hulakov/NosLed/hardware/NosLed.kicad_pcb

## KiCad design hardware/NosLed.kicad_pcb (2026-04-08)

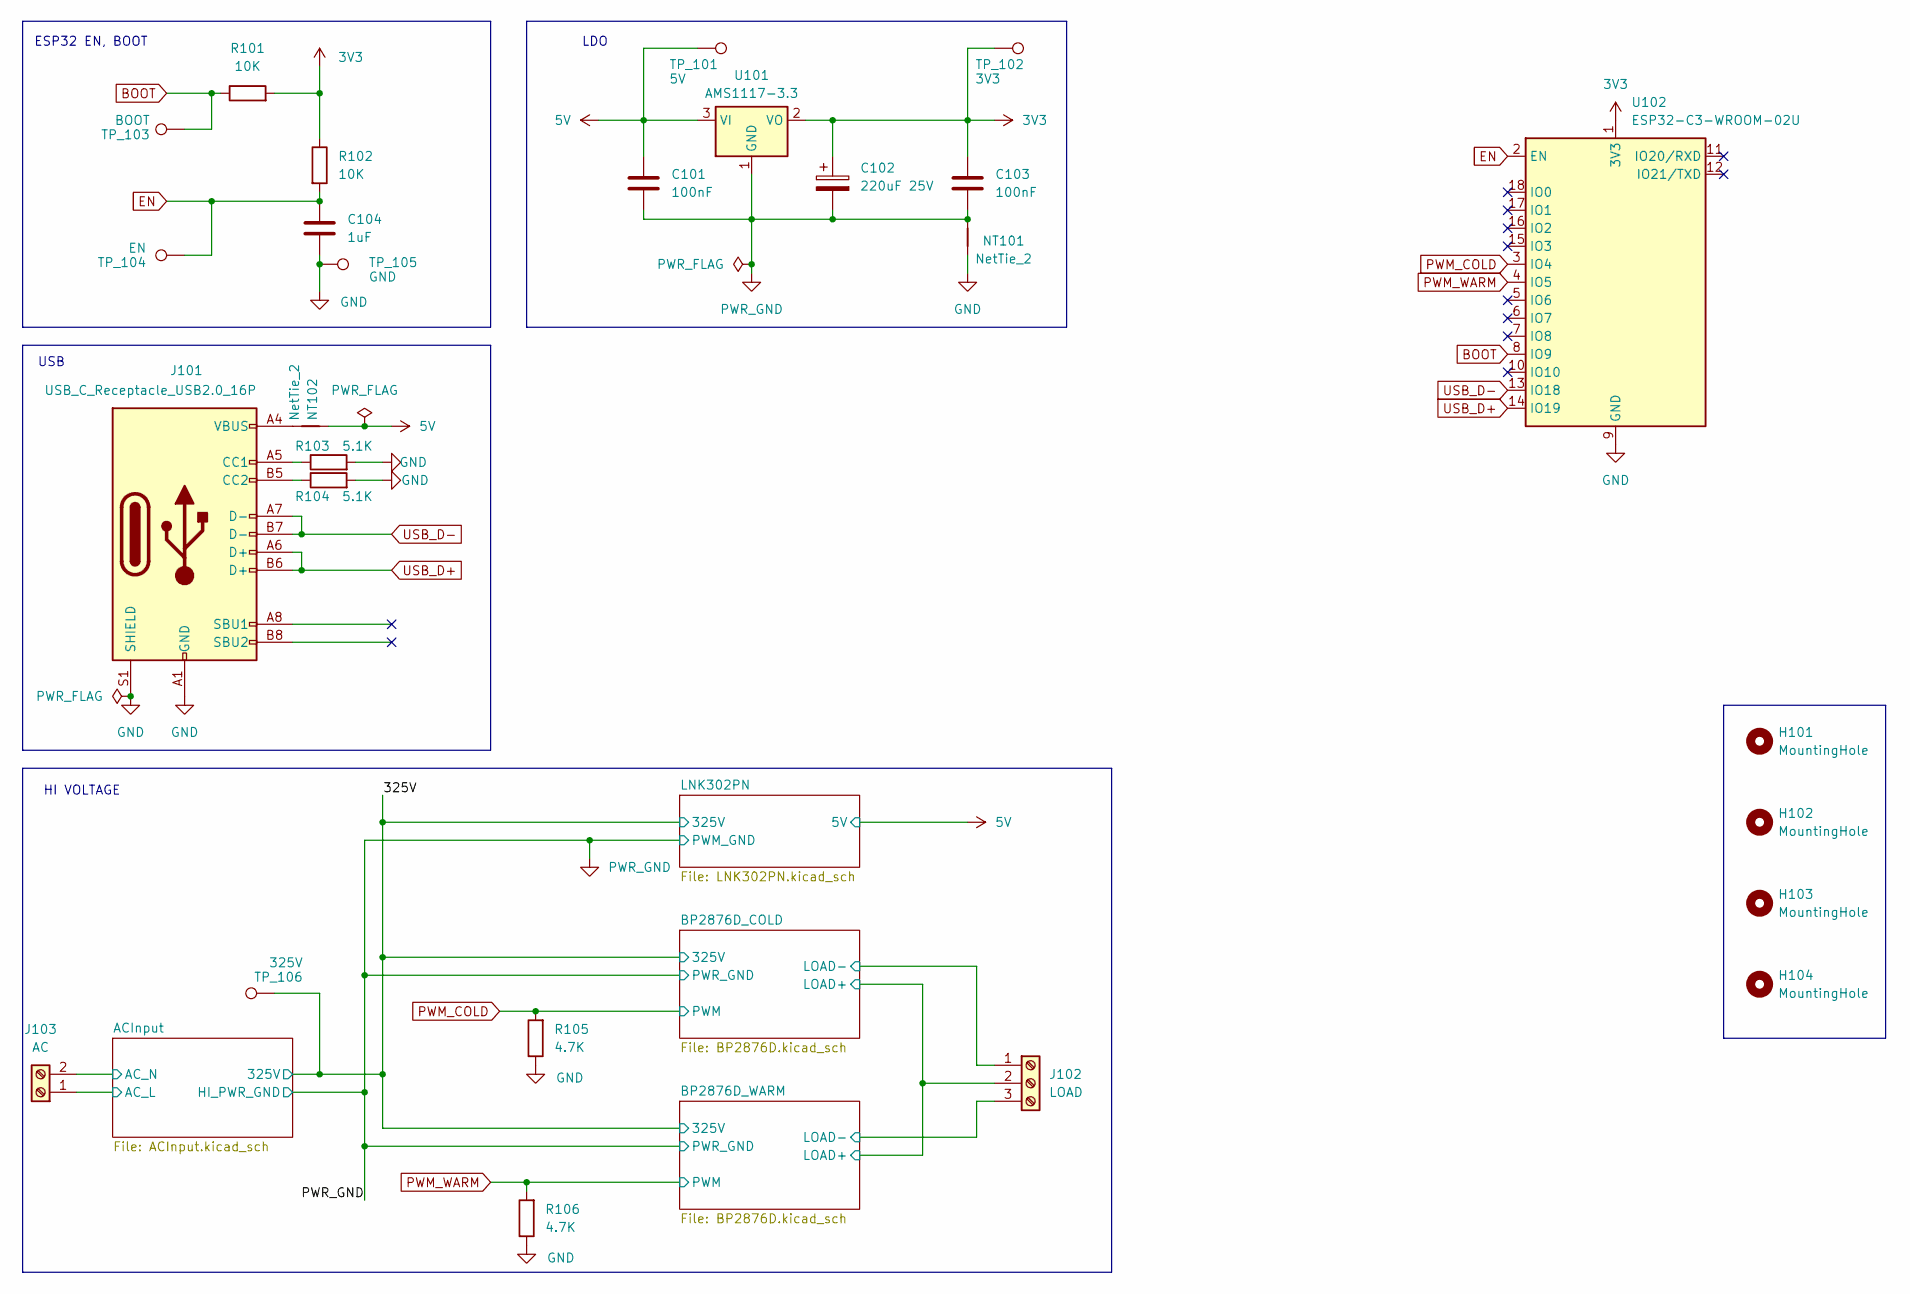
[picture p1: schematic NosLed.kicad_sch]

Parts:
C101, C103: 100nF; C_0603_1608Metric
C102: 220uF 25V; CP_Radial_D6.3mm_P2.50mm
C104: 1uF; C_0805_2012Metric
H101, H102, H103, H104: MountingHole; MountingHole_3.2mm_M3
J101: USB_C_Receptacle_USB2.0_16P; USB_C_Receptacle_HRO_TYPE-C-31-M-12
J102: LOAD; TerminalBlock_Phoenix_MKDS-1,5-3-5.08_1x03_P5.08mm_Horizont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
J103: AC; TerminalBlock_Phoenix_MKDS-1,5-2-5.08_1x02_P5.08mm_Horizont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
NT101, NT102: NetTie_2; NetTie-2_SMD_Pad0.5mm
R101, R102: 10K; R_0603_1608Metric
R103, R104: 5.1K; R_0603_1608Metric
R105, R106: 4.7K; R_0603_1608Metric
TP_101: 5V; TestPoint_Pad_1.0x1.0mm
TP_102: 3V3; TestPoint_Pad_1.0x1.0mm
TP_103: BOOT; TestPoint_Pad_1.0x1.0mm
TP_104: EN; TestPoint_Pad_1.0x1.0mm
TP_105: GND; TestPoint_Pad_1.0x1.0mm
TP_106: 325V; TestPoint_Pad_1.0x1.0mm
U101: AMS1117-3.3; SOT-223-3_TabPin2
U102: ESP32-C3-WROOM-02U

Connections:
3V3: C102.1, C103.2, R101.2, R102.1, TP_102.1, U101.2 (VO), U102.1 (3V3)
5V: C101.2, NT102.2, TP_101.1, U101.3 (VI); also elsewhere on the board
/325V: J102.2, TP_106.1; also elsewhere on the board
/ACInput/AC_L: J103.1; also elsewhere on the board
/ACInput/AC_N: J103.2; also elsewhere on the board
/BP2876D_COLD/LOAD-: J102.1; also elsewhere on the board
/BP2876D_WARM/LOAD-: J102.3; also elsewhere on the board
BOOT: R101.1, TP_103.1, U102.8 (IO9)
EN: C104.1, R102.2, TP_104.1, U102.2 (EN)
GND: C104.2, J101.A1 (GND), J101.A12 (GND), J101.B1 (GND), J101.B12 (GND), J101.S1 (SHIELD), NT101.2, R103.2, R104.2, R105.1, R106.1, TP_105.1, U102.9 (GND), U102.19 (GND); also elsewhere on the board
unnamed: J101.A5 (CC1), R103.1
unnamed: J101.B5 (CC2), R104.1
unnamed: J101.A4 (VBUS), J101.A9 (VBUS), J101.B4 (VBUS), J101.B9 (VBUS), NT102.1
PWM_COLD: R105.2, U102.3 (IO4); also elsewhere on the board
PWM_WARM: R106.2, U102.4 (IO5); also elsewhere on the board
PWR_GND: C101.1, C102.2, C103.1, NT101.1, U101.1 (GND); also elsewhere on the board
USB_D+: J101.A6 (D+), J101.B6 (D+), U102.14 (IO19)
USB_D-: J101.A7 (D-), J101.B7 (D-), U102.13 (IO18)

Notes on the sheet:
LDO
ESP32 EN, BOOT
HI VOLTAGE
USB

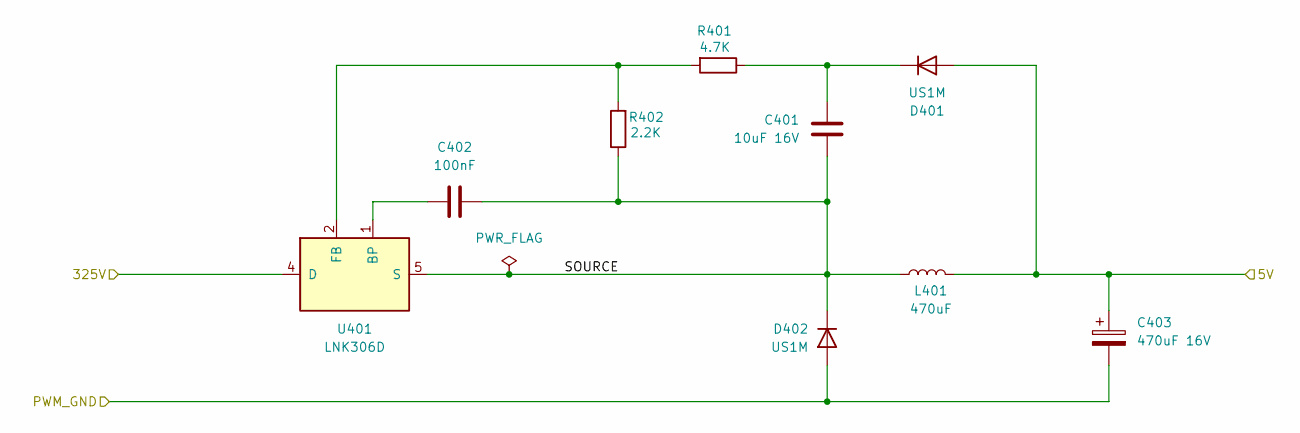
[picture p2: schematic LNK302PN.kicad_sch]

Parts:
C401: 10uF 16V; C_0805_2012Metric
C402: 100nF; C_0603_1608Metric
C403: 470uF 16V; CP_Radial_D8.0mm_P5.00mm
D401, D402: US1M; D_SMA
L401: 470uF; L_Radial_D9.5mm_P5.00mm_Fastron_07HVP
R401: 4.7K; R_0603_1608Metric
R402: 2.2K; R_0603_1608Metric
U401: LNK306D; LNK302PN-SOIC-8_3.9x4.9mm_P1.27mm

Connections:
5V: C403.1, D401.2 (A), L401.2; also elsewhere on the board
/325V: U401.4 (D); also elsewhere on the board
/LNK302PN/SOURCE: C401.1, C402.1, D402.1 (K), L401.1, R402.1, U401.5 (S), U401.6 (S), U401.7 (S), U401.8 (S)
unnamed: C401.2, D401.1 (K), R401.1
unnamed: C402.2, U401.1 (BP)
unnamed: R401.2, R402.2, U401.2 (FB)
PWR_GND: C403.2, D402.2 (A); also elsewhere on the board

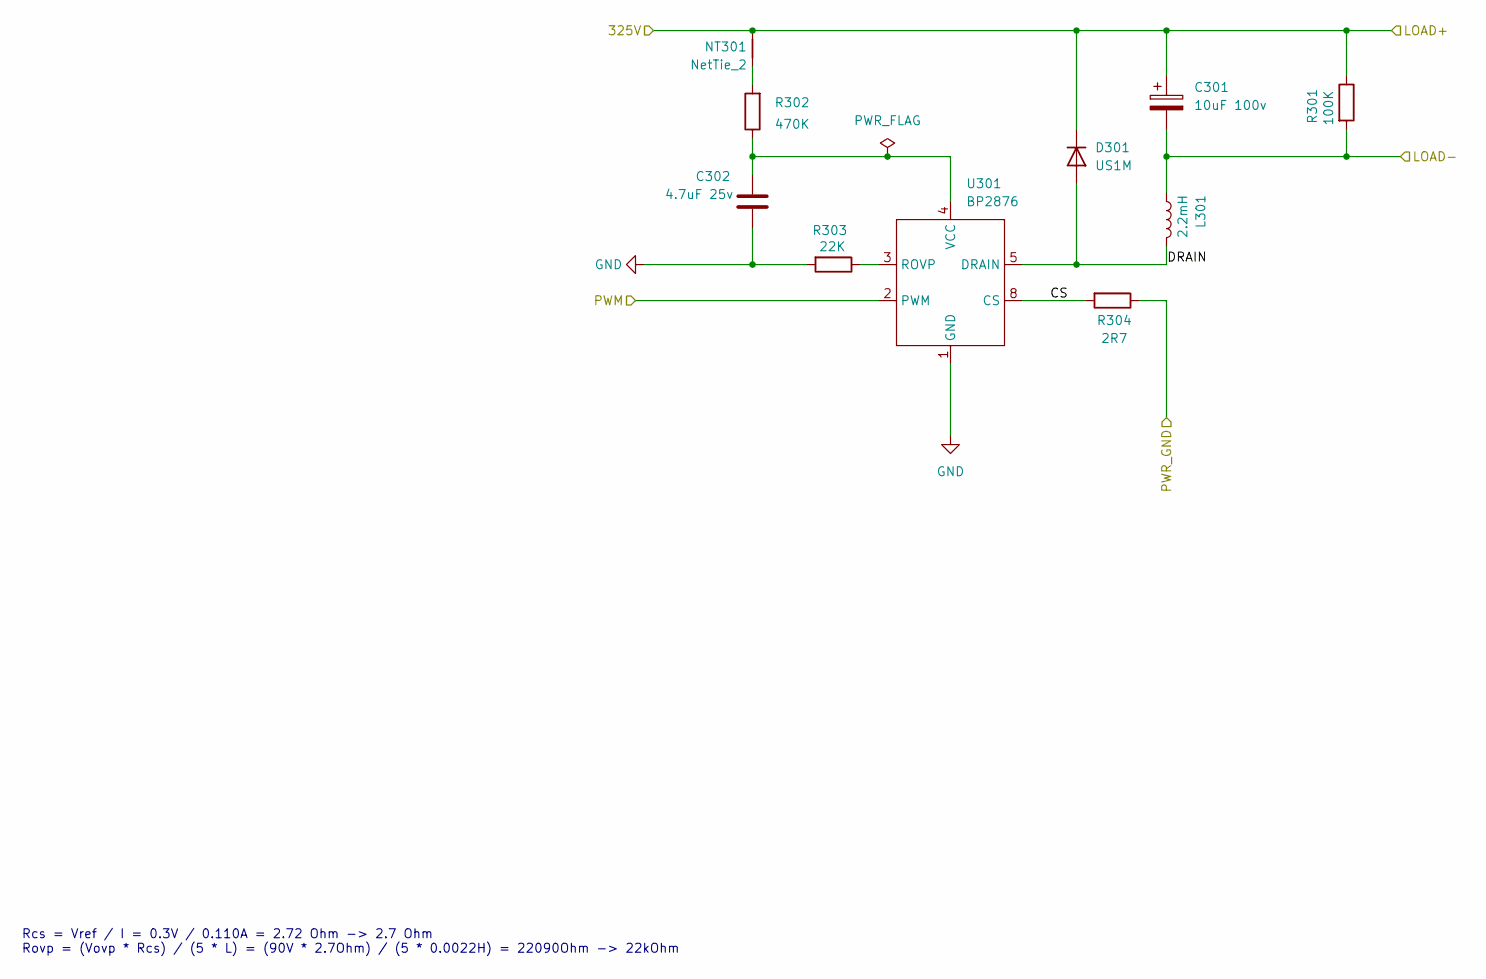
[picture p3: schematic BP2876D.kicad_sch]

Parts:
C301: 10uF 100v; CP_Radial_D6.3mm_P2.50mm
C302: 4.7uF 25v; C_0805_2012Metric
D301: US1M; D_SMA
L301: 2.2mH; L_Radial_D9.5mm_P5.00mm_Fastron_07HVP
NT301: NetTie_2; NetTie-2_SMD_Pad0.5mm
R301: 100К; R_1206_3216Metric
R302: 470K; R_2512_6332Metric
R303: 22K; R_0603_1608Metric
R304: 2R7; R_0805_2012Metric
U301: BP2876; SOIC-8-N7_3.9x4.9mm_P1.27mm

Connections:
/325V: C301.1, D301.1 (K), NT301.2, R301.1; also elsewhere on the board
/BP2876D_WARM/CS: R304.2, U301.8 (CS)
/BP2876D_WARM/DRAIN: D301.2 (A), L301.2, U301.5 (DRAIN), U301.6 (DRAIN)
/BP2876D_WARM/LOAD-: C301.2, L301.1, R301.2; also elsewhere on the board
GND: C302.2, R303.2, U301.1 (GND); also elsewhere on the board
unnamed: NT301.1, R302.2
unnamed: R303.1, U301.3 (ROVP)
unnamed: C302.1, R302.1, U301.4 (VCC)
PWM_WARM: U301.2 (PWM); also elsewhere on the board
PWR_GND: R304.1; also elsewhere on the board

Parts of its further copies:
C501: 10uF 100v; CP_Radial_D6.3mm_P2.50mm
C502: 4.7uF 25v; C_0805_2012Metric
D501: US1M; D_SMA
L501: 2.2mH; L_Radial_D9.5mm_P5.00mm_Fastron_07HVP
NT501: NetTie_2; NetTie-2_SMD_Pad0.5mm
R501: 100К; R_1206_3216Metric
R502: 470K; R_2512_6332Metric
R503: 22K; R_0603_1608Metric
R504: 2R7; R_0805_2012Metric
U501: BP2876; SOIC-8-N7_3.9x4.9mm_P1.27mm

Connections of its further copies:
/325V: C501.1, D501.1 (K), NT501.2, R501.1; also elsewhere on the board
/BP2876D_COLD/CS: R504.2, U501.8 (CS)
/BP2876D_COLD/DRAIN: D501.2 (A), L501.2, U501.5 (DRAIN), U501.6 (DRAIN)
/BP2876D_COLD/LOAD-: C501.2, L501.1, R501.2; also elsewhere on the board
GND: C502.2, R503.2, U501.1 (GND); also elsewhere on the board
unnamed: NT501.1, R502.2
unnamed: R503.1, U501.3 (ROVP)
unnamed: C502.1, R502.1, U501.4 (VCC)
PWM_COLD: U501.2 (PWM); also elsewhere on the board
PWR_GND: R504.1; also elsewhere on the board

Notes on the sheet:
Rcs = Vref / I = 0.3V / 0.110A = 2.72 Ohm -> 2.7 Ohm Rovp = (Vovp * Rcs) / (5 * L) = (90V * 2.7Ohm) / (5 * 0.0022H) = 22090Ohm -> 22kOhm

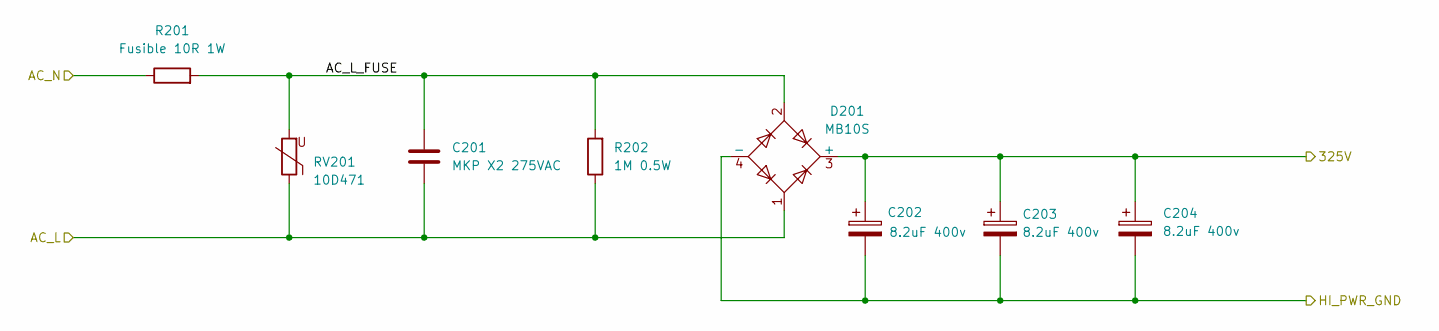
[picture p4: schematic ACInput.kicad_sch]

Parts:
C201: MKP X2 275VAC; C_Rect_L13.0mm_W6.0mm_P10.00mm_FKS3_FKP3_MKS4
C202, C203, C204: 8.2uF 400v; CP_Radial_D8.0mm_P3.50mm
D201: MB10S; TO-269AA
R201: Fusible 10R 1W; R_Axial_DIN0414_L11.9mm_D4.5mm_P15.24mm_Horizontal
R202: 1M 0.5W; R_2512_6332Metric
RV201: 10D471; RV_Disc_D12mm_W4.8mm_P7.5mm

Connections:
/325V: C202.1, C203.1, C204.1, D201.3 (+); also elsewhere on the board
/ACInput/AC_L: C201.2, D201.1, R202.1, RV201.1; also elsewhere on the board
/ACInput/AC_L_FUSE: C201.1, D201.2, R201.2, R202.2, RV201.2
/ACInput/AC_N: R201.1; also elsewhere on the board
PWR_GND: C202.2, C203.2, C204.2, D201.4 (-); also elsewhere on the board

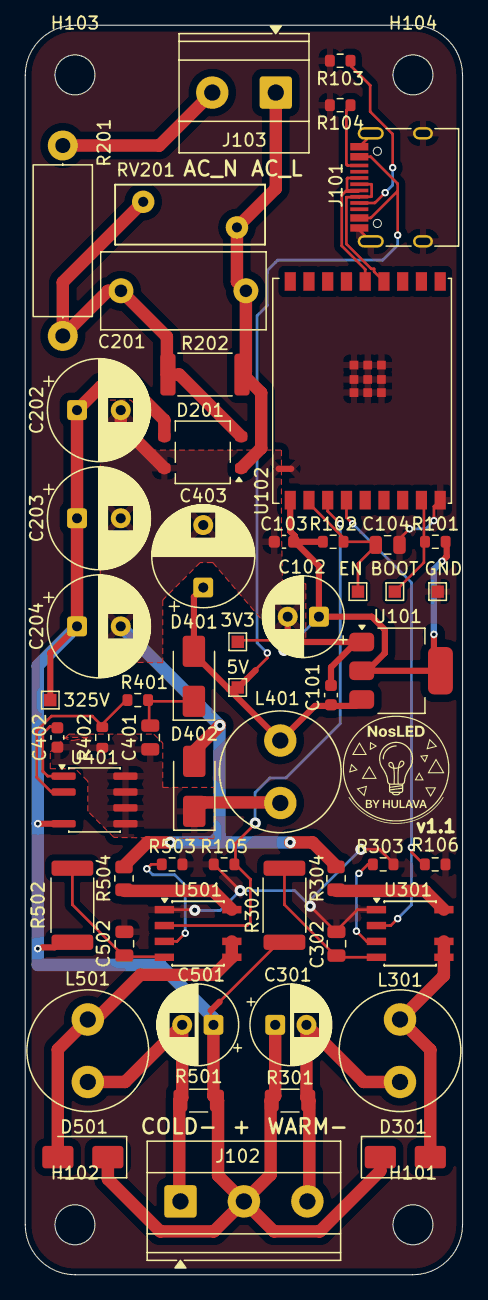
[picture p5: board NosLed.kicad_pcb from above]

Board: 2 copper layers, 35.0 x 100.0 mm, 64 parts (0 on the bottom side), 33 nets.
