hulakov/NosLed/(commit log)

2026-02-04 AC Input
    [ACInput.kicad_sch, BP2876.kicad_sch, NosLed.kicad_pcb, NosLed.kicad_sch]
2026-02-08 Tracing draft
    [ACInput.kicad_sch, BP2876.kicad_sch, BP2876D.kicad_sch, BP2956XS.kicad_sch, LNK302PN.kicad_sch, NosLed.kicad_pcb, NosLed.kicad_sch]
2026-02-11 Tracing 0.2
    [ACInput.kicad_sch, BP2876D.kicad_sch, LNK302PN.kicad_sch, NosLed.kicad_pcb, NosLed.kicad_sch]
2026-02-11 Version 1
    [LNK302PN.kicad_sch, NosLed.kicad_pcb]
2026-02-27 Use non-hand soldering footprints
    [ACInput.kicad_sch, BP2876D.kicad_sch, LNK302PN.kicad_sch, NosLed.kicad_pcb, NosLed.kicad_sch]
2026-04-08 Fix holes
    [NosLed.kicad_pcb, NosLed.kicad_sch]
